OhBlimeyISpilledMySoupOnTheCarpet/Oh-dear-god-the-lemurs-have-escaped-again/README.md

# Oh-dear-god-the-lemurs-have-escaped-again
