OhBlimeyISpilledMySoupOnTheCarpet/Oh-dear-god-the-lemurs-have-escaped-again/Models/Head/Spike Plate V2.stl

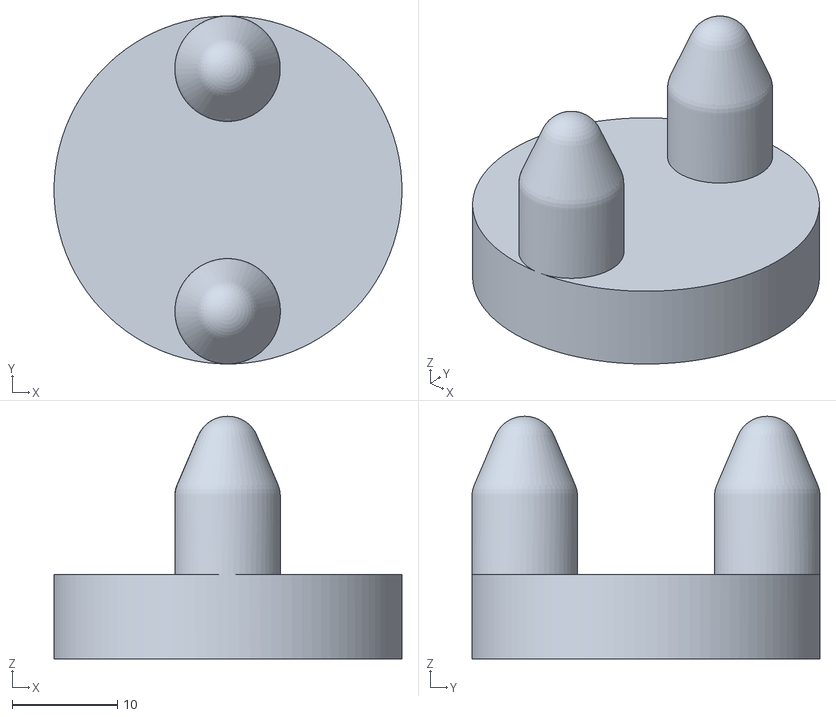
[picture p2: CAD file, 2019-08-18]
Models/Head/Spike Plate V2.stl
33.0 x 33.0 x 23.0
