OhBlimeyISpilledMySoupOnTheCarpet/Oh-dear-god-the-lemurs-have-escaped-again/Models/Other/Controller Case Base.stl

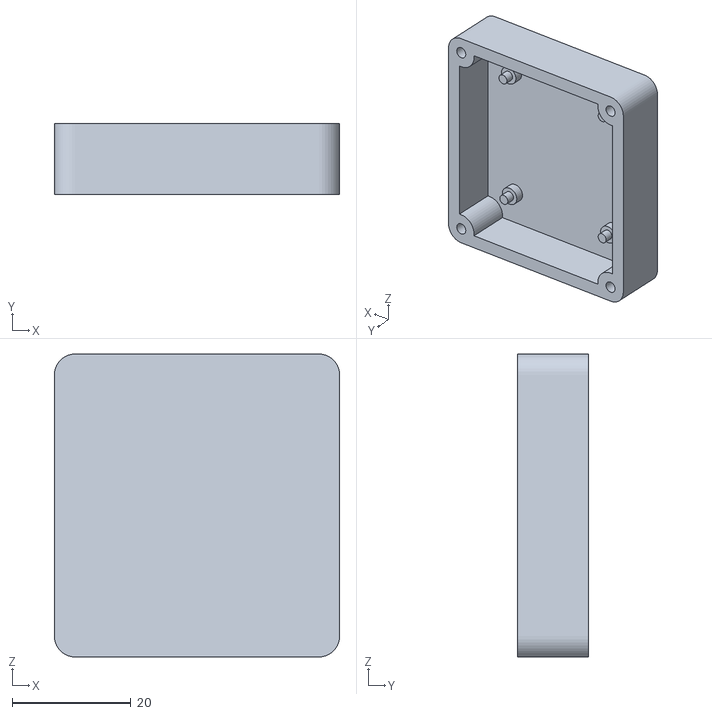
[picture p3: CAD file, 2019-09-10]
Models/Other/Controller Case Base.stl
48.0 x 12.0 x 51.0
