OhBlimeyISpilledMySoupOnTheCarpet/Oh-dear-god-the-lemurs-have-escaped-again/Models/Arm/Tie Plate Thicc.stl

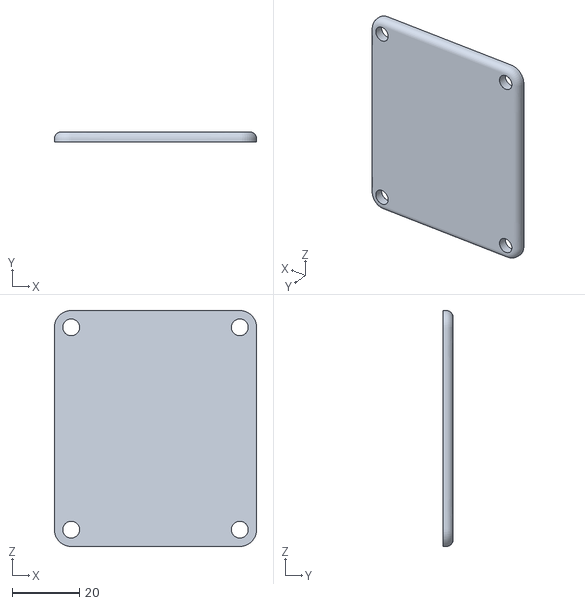
[picture p4: CAD file, 2019-09-10]
Models/Arm/Tie Plate Thicc.stl
60.0 x 3.00 x 70.0
