OhBlimeyISpilledMySoupOnTheCarpet/Oh-dear-god-the-lemurs-have-escaped-again/Models/Head/Box.stl

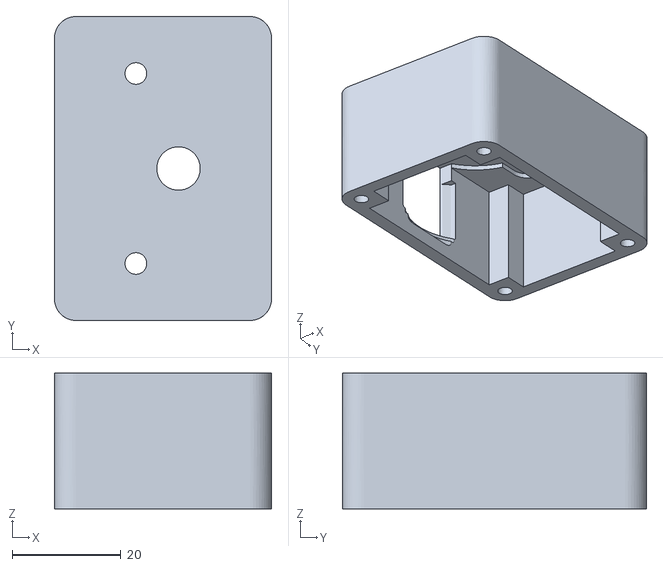
[picture p5: CAD file, 2019-08-06]
Models/Head/Box.stl
40.0 x 56.0 x 25.0
