OhBlimeyISpilledMySoupOnTheCarpet/Oh-dear-god-the-lemurs-have-escaped-again/Models/Other/Controller Case Lid.stl

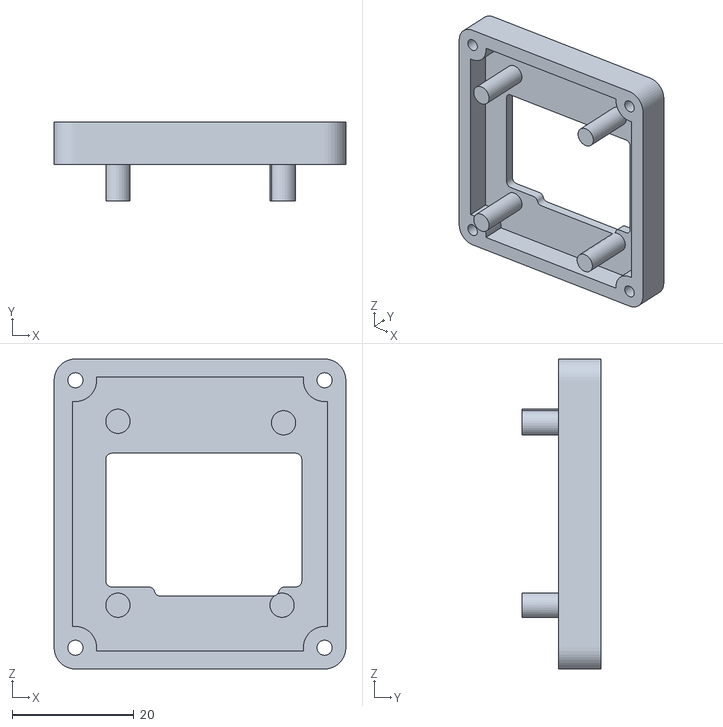
[picture p6: CAD file, 2019-09-10]
Models/Other/Controller Case Lid.stl
48.0 x 13.0 x 51.0
