OhBlimeyISpilledMySoupOnTheCarpet/Oh-dear-god-the-lemurs-have-escaped-again/Models/Arm/Stalk No Hook V2.stl

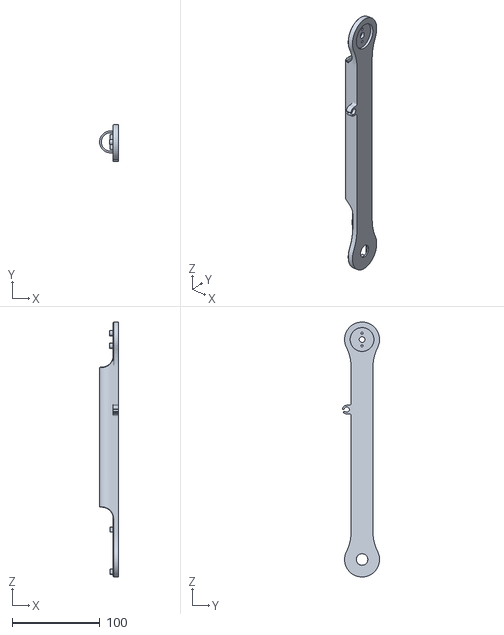
[picture p7: CAD file, 2019-09-10]
Models/Arm/Stalk No Hook V2.stl
21.5 x 42.3 x 291.2
