OhBlimeyISpilledMySoupOnTheCarpet/Oh-dear-god-the-lemurs-have-escaped-again/Models/Other/Controller Case Base Test.stl

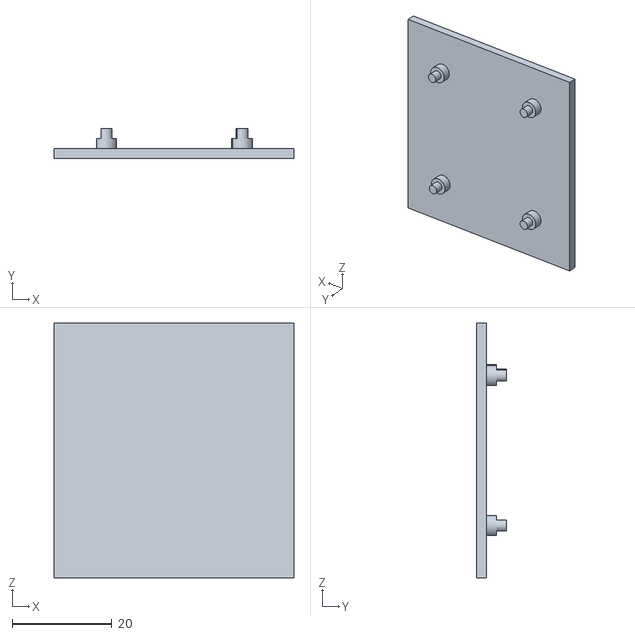
[picture p8: CAD file, 2019-09-10]
Models/Other/Controller Case Base Test.stl
48.0 x 6.00 x 51.0
