OhBlimeyISpilledMySoupOnTheCarpet/Oh-dear-god-the-lemurs-have-escaped-again/Models/Arm/Stalk No Hook.stl

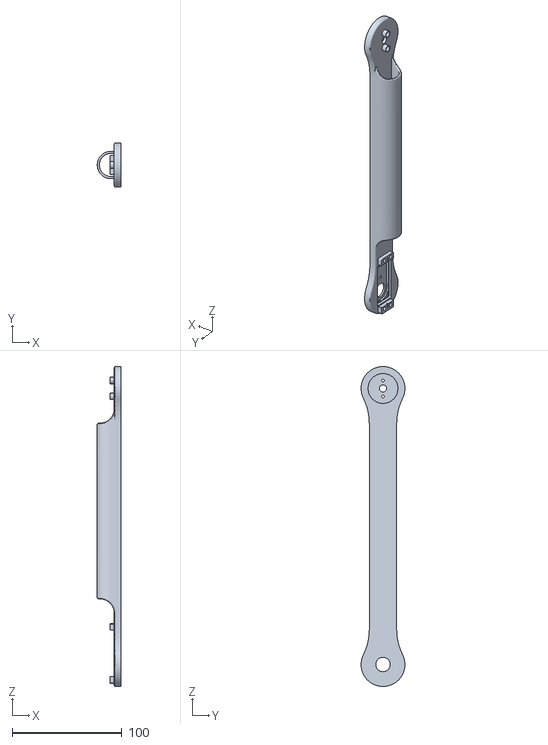
[picture p9: CAD file, 2019-09-10]
Models/Arm/Stalk No Hook.stl
21.5 x 39.9 x 291.2
