OhBlimeyISpilledMySoupOnTheCarpet/Oh-dear-god-the-lemurs-have-escaped-again/Models/Arm/Lid.stl

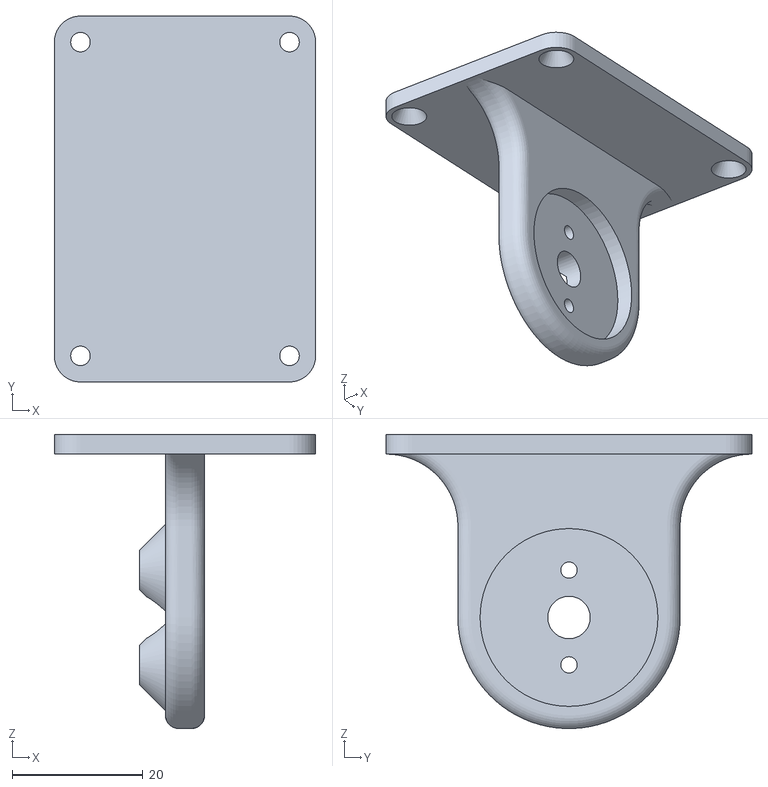
[picture p10: CAD file, 2019-09-10]
Models/Arm/Lid.stl
40.0 x 56.0 x 45.0
