OhBlimeyISpilledMySoupOnTheCarpet/Oh-dear-god-the-lemurs-have-escaped-again/Models/Head/Lid.stl

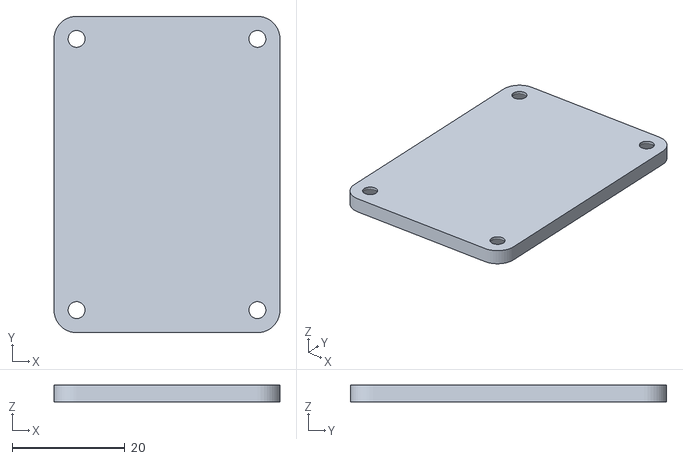
[picture p11: CAD file, 2019-08-06]
Models/Head/Lid.stl
40.0 x 56.0 x 3.00
