OhBlimeyISpilledMySoupOnTheCarpet/Oh-dear-god-the-lemurs-have-escaped-again/Models/Arm/Stalk.stl

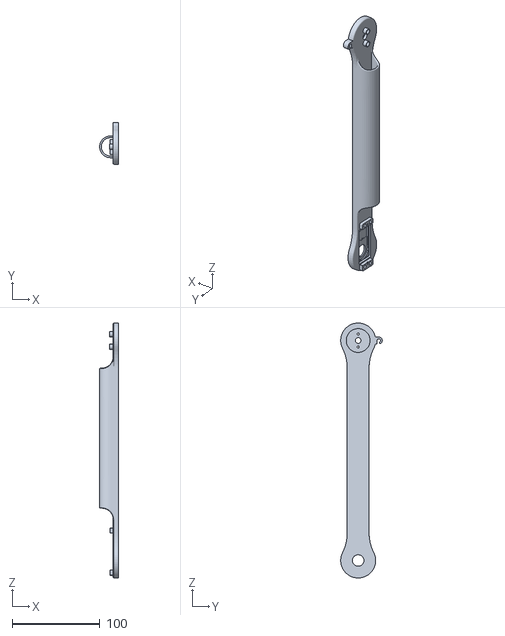
[picture p12: CAD file, 2019-09-10]
Models/Arm/Stalk.stl
21.5 x 47.5 x 291.2
