OhBlimeyISpilledMySoupOnTheCarpet/Oh-dear-god-the-lemurs-have-escaped-again/Models/Arm/Tie Plate.stl

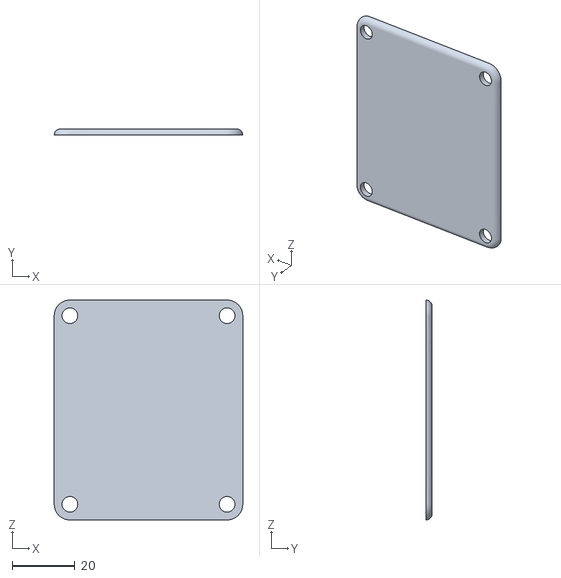
[picture p13: CAD file, 2019-09-10]
Models/Arm/Tie Plate.stl
60.0 x 2.00 x 70.0
