OhBlimeyISpilledMySoupOnTheCarpet/Oh-dear-god-the-lemurs-have-escaped-again/Models/Arm/Stalk V2.stl

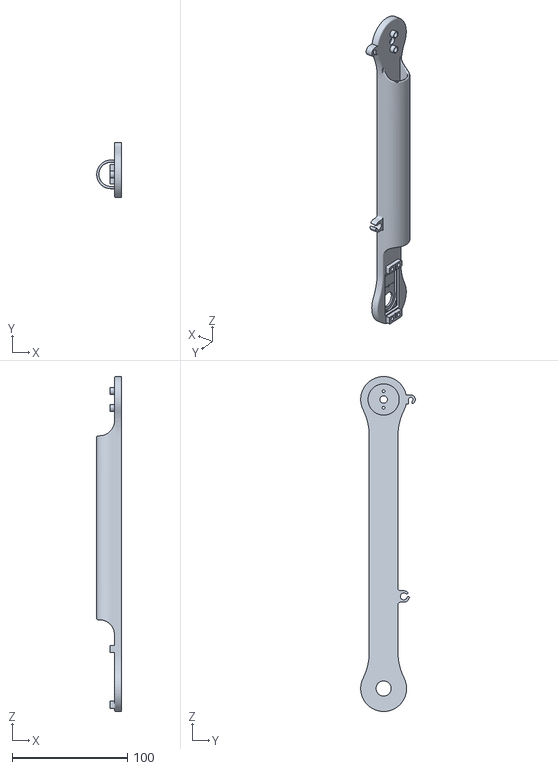
[picture p14: CAD file, 2019-09-10]
Models/Arm/Stalk V2.stl
21.5 x 47.5 x 291.2
