OhBlimeyISpilledMySoupOnTheCarpet/Oh-dear-god-the-lemurs-have-escaped-again/Models/Arm/Base V3.stl

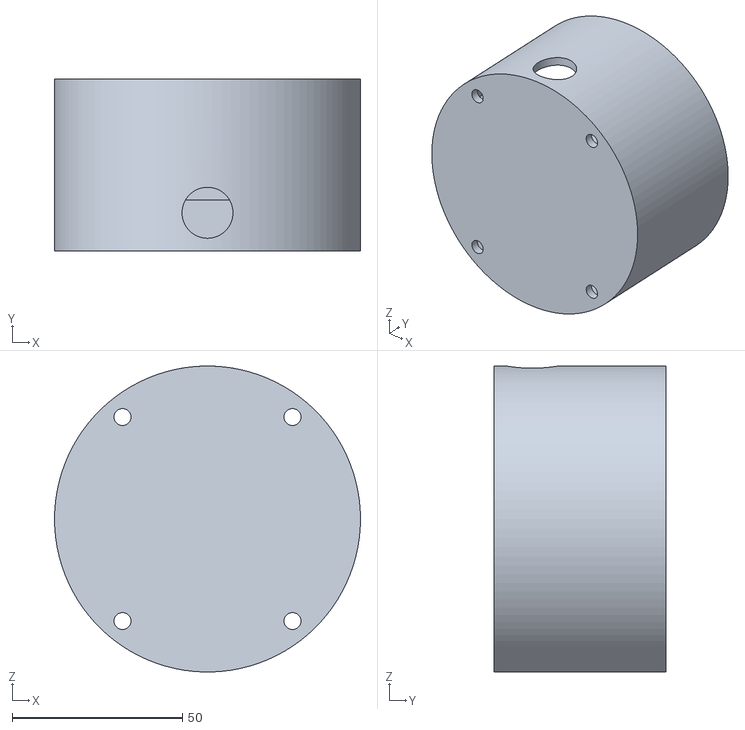
[picture p15: CAD file, 2019-09-10]
Models/Arm/Base V3.stl
90.0 x 50.7 x 90.0
