OhBlimeyISpilledMySoupOnTheCarpet/Oh-dear-god-the-lemurs-have-escaped-again/Models/Arm/Base Cap.stl

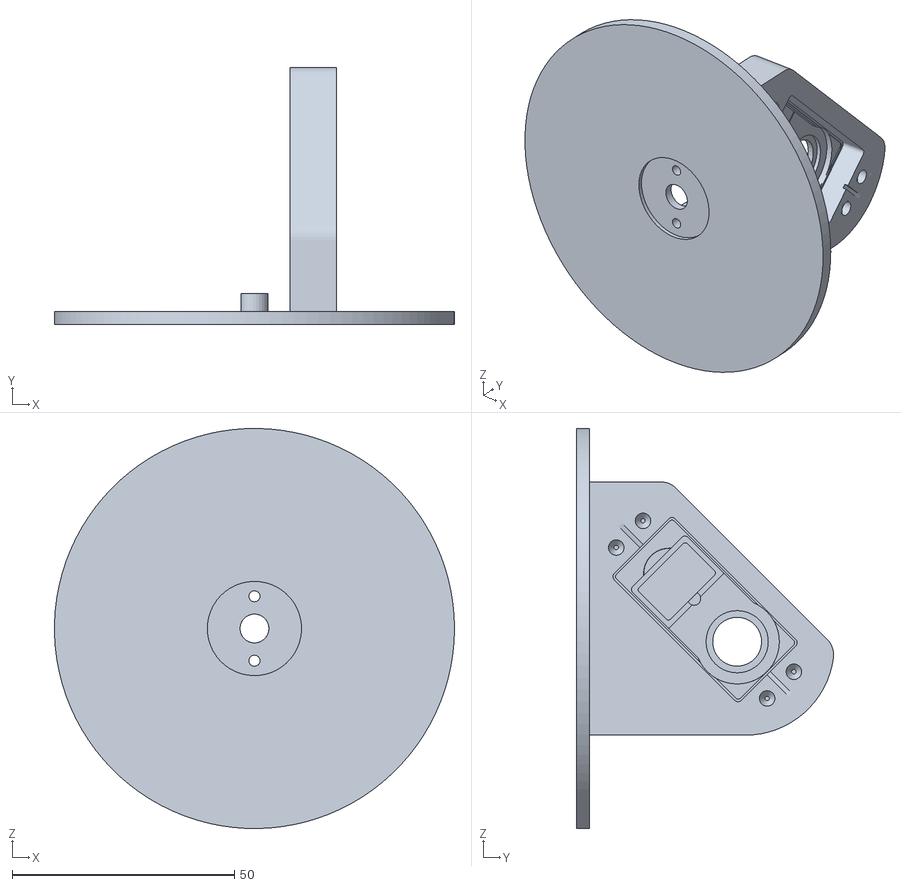
[picture p16: CAD file, 2019-08-18]
Models/Arm/Base Cap.stl
90.0 x 57.9 x 90.0
