OhBlimeyISpilledMySoupOnTheCarpet/Oh-dear-god-the-lemurs-have-escaped-again/Models/Head/Spike Plate.stl

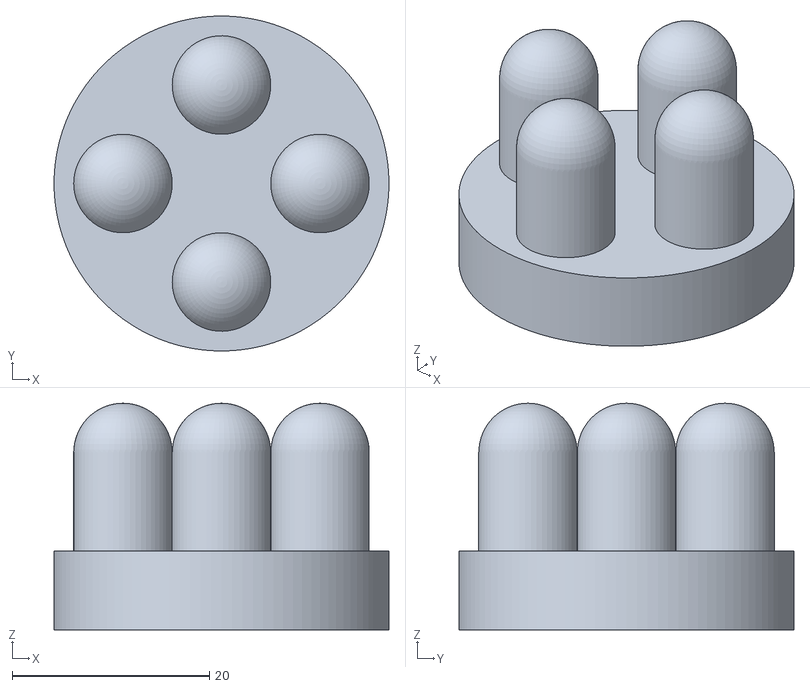
[picture p17: CAD file, 2019-08-06, an earlier design]
Models/Head/Spike Plate.stl
34.0 x 34.0 x 23.0
