OhBlimeyISpilledMySoupOnTheCarpet/Oh-dear-god-the-lemurs-have-escaped-again/(list of files, cad)

Other CAD files:
Models/Head/Box Easy Print.stl
Models/Arm/Base V2.stl
Models/Arm/Base.stl
Models/Component Imports/Servo MG996R.f3d
Models/Component Imports/ULN2003 Stepper Driver.stp.77827b7b-c24a-4f4c-a0d9-50f4389b5884.f3d
