OhBlimeyISpilledMySoupOnTheCarpet/Oh-dear-god-the-lemurs-have-escaped-again/(commit log)

2019-07-21 End of First Sprint
    [Tasks.xlsx]
2019-08-04 End of sprint 2
    [Servo MG996R.f3d, ULN2003 Stepper Driver.stp.77827b7b-c24a-4f4c-a0d9-50f4389b5884.f3d]
2019-08-06 Sprint 2 Review
    [Box Easy Print.stl, Box.stl, Lid.stl, Servo MG996R.f3d, Spike Plate.stl, Tasks.xlsx, ULN2003 Stepper Driver.stp.77827b7b-c24a-4f4c-a0d9-50f4389b5884.f3d]
2019-08-18 Sprint 3 Due
    [Base Cap.stl, Base.stl, Spike Plate V2.stl]
2019-09-10 Pre-sprint 4 paperwork
    [Base V2.stl, Base V3.stl, Controller Case Base Test.stl, Controller Case Base.stl, Controller Case Lid.stl, Lid.stl, Stalk No Hook V2.stl, Stalk No Hook.stl]
